dimomite/laser_lever_platform/README.md

# laser lever platform
Platform for remote adjustment rotation and position of a laser level
