dimomite/laser_lever_platform/hardware/mainboard/LaserLevelPlatform/LaserLevelPlatform.kicad_pcb

## KiCad design hardware/mainboard/LaserLevelPlatform/LaserLevelPlatform.kicad_pcb (2022-09-18)

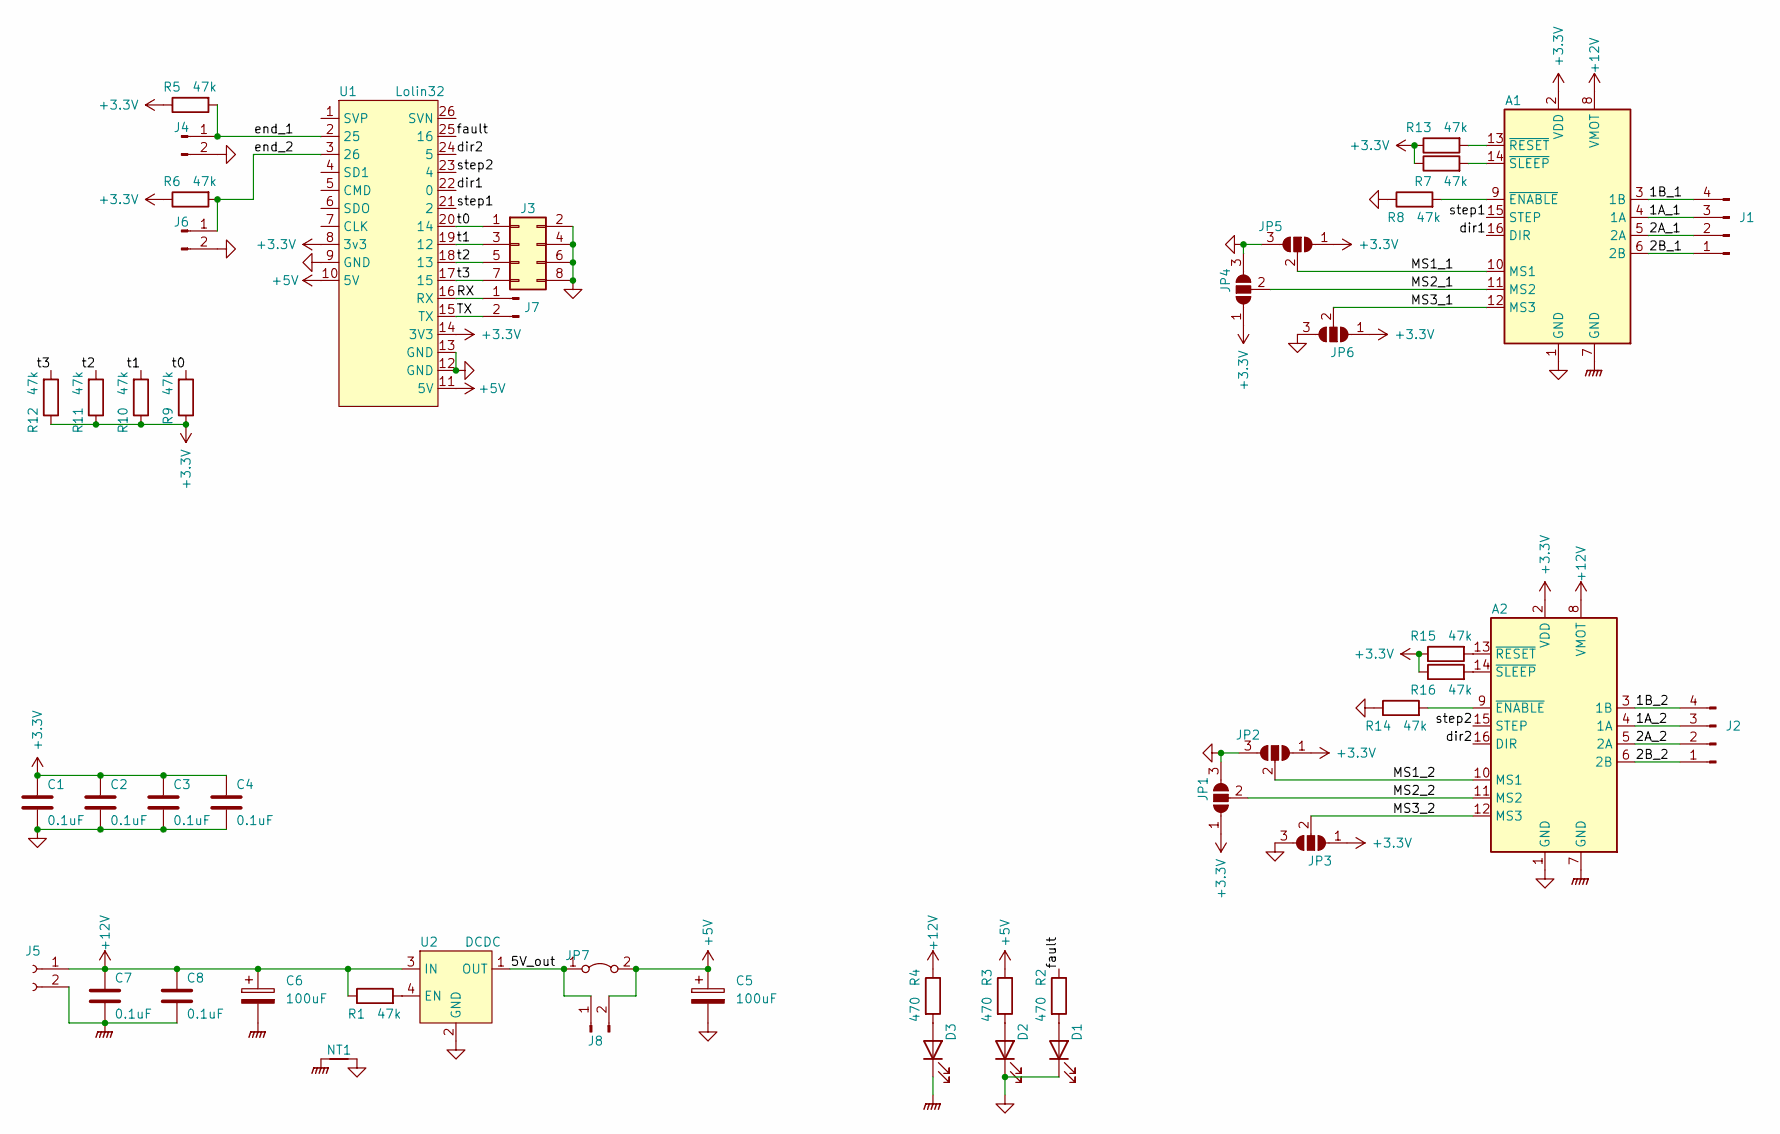
[picture p1: schematic LaserLevelPlatform.kicad_sch]

Parts:
A1, A2: Pololu_Breakout_A4988; Pololu_Breakout-16_15.2x20.3mm
C1, C2, C3, C4, C7, C8: 0.1uF; C_0805_2012Metric_Pad1.18x1.45mm_HandSolder
C5: 100uF; CP_Radial_D10.0mm_P2.50mm_P5.00mm
C6: 100uF; CP_Radial_D10.0mm_P5.00mm
D1, D2, D3: LED; LED_D5.0mm
J1, J2: Conn_01x04_Male; JST_EH_B4B-EH-A_1x04_P2.50mm_Vertical
J3: Conn_02x04_Odd_Even; PinHeader_2x04_P2.54mm_Vertical
J4, J6: Conn_01x02_Male; JST_EH_B2B-EH-A_1x02_P2.50mm_Vertical
J5: Conn_01x02_Female; PhoenixContact_MSTBVA_2,5_2-G-5,08_1x02_P5.08mm_Vertical
J7, J8: Conn_01x02_Male; PinHeader_1x02_P2.54mm_Vertical
JP1, JP2, JP3, JP4, JP5, JP6: SolderJumper_3_Open; SolderJumper-3_P2.0mm_Open_TrianglePad1.0x1.5mm
JP7: Jumper_2_Bridged; SolderJumper-2_P1.3mm_Open_TrianglePad1.0x1.5mm
NT1: NetTie_2; NetTie-2_SMD_Pad2.0mm
R1, R5, R6, R7, R8, R9, R10, R11, R12, R13, R14, R15, R16: 47k; R_0805_2012Metric_Pad1.20x1.40mm_HandSolder
R2, R3, R4: 470; R_0805_2012Metric_Pad1.20x1.40mm_HandSolder
U1: Lolin32
U2: DCDC

Connections:
+3.3V: A1.2 (VDD), A2.2 (VDD), C1.1, C2.1, C3.1, C4.1, JP1.1 (A), JP2.1 (A), JP3.1 (A), JP4.1 (A), JP5.1 (A), JP6.1 (A), R5.1, R6.1, R7.1, R9.1, R10.1, R11.1, R12.1, R13.1, R15.1, R16.1, U1.8 (3v3), U1.14 (3V3)
+5V: C5.1, J8.2, JP7.2 (B), R3.1, U1.10 (5V), U1.11 (5V)
+12V: A1.8 (VMOT), A2.8 (VMOT), C6.1, C7.1, C8.1, J5.1, R1.1, R4.1, U2.3 (IN)
/1A_1: A1.4 (1A), J1.3
/1A_2: A2.4 (1A), J2.3
/1B_1: A1.3 (1B), J1.4
/1B_2: A2.3 (1B), J2.4
/2A_1: A1.5 (2A), J1.2
/2A_2: A2.5 (2A), J2.2
/2B_1: A1.6 (2B), J1.1
/2B_2: A2.6 (2B), J2.1
/5V_out: J8.1, JP7.1 (A), U2.1 (OUT)
/MS1_1: A1.10 (MS1), JP5.2 (C)
/MS1_2: A2.10 (MS1), JP2.2 (C)
/MS2_1: A1.11 (MS2), JP4.2 (C)
/MS2_2: A2.11 (MS2), JP1.2 (C)
/MS3_1: A1.12 (MS3), JP6.2 (C)
/MS3_2: A2.12 (MS3), JP3.2 (C)
/RX: J7.1, U1.16 (RX)
/TX: J7.2, U1.15 (TX)
/dir1: A1.16 (DIR), U1.22 (0)
/dir2: A2.16 (DIR), U1.24 (5)
/end_1: J4.1, R5.2, U1.2 (25)
/end_2: J6.1, R6.2, U1.3 (26)
/fault: R2.1, U1.25 (16)
/step1: A1.15 (STEP), U1.21 (2)
/step2: A2.15 (STEP), U1.23 (4)
/t0: J3.1, R9.2, U1.20 (14)
/t1: J3.3, R10.2, U1.19 (12)
/t2: J3.5, R11.2, U1.18 (13)
/t3: J3.7, R12.2, U1.17 (15)
GND: A1.1 (GND), A2.1 (GND), C1.2, C2.2, C3.2, C4.2, C5.2, D1.1 (K), D2.1 (K), J3.2, J3.4, J3.6, J3.8, J4.2, J6.2, JP1.3 (B), JP2.3 (B), JP3.3 (B), JP4.3 (B), JP5.3 (B), JP6.3 (B), NT1.2, R8.1, R14.1, U1.9 (GND), U1.12 (GND), U1.13 (GND), U2.2 (GND)
GNDPWR: A1.7 (GND), A2.7 (GND), C6.2, C7.2, C8.2, D3.1 (K), J5.2, NT1.1
unnamed: A1.9 (~ENABLE), R8.2
unnamed: A1.13 (~RESET), R13.2
unnamed: A1.14 (~SLEEP), R7.2
unnamed: A2.9 (~ENABLE), R14.2
unnamed: A2.13 (~RESET), R15.2
unnamed: A2.14 (~SLEEP), R16.2
unnamed: D1.2 (A), R2.2
unnamed: D2.2 (A), R3.2
unnamed: D3.2 (A), R4.2
unnamed: R1.2, U2.4 (EN)

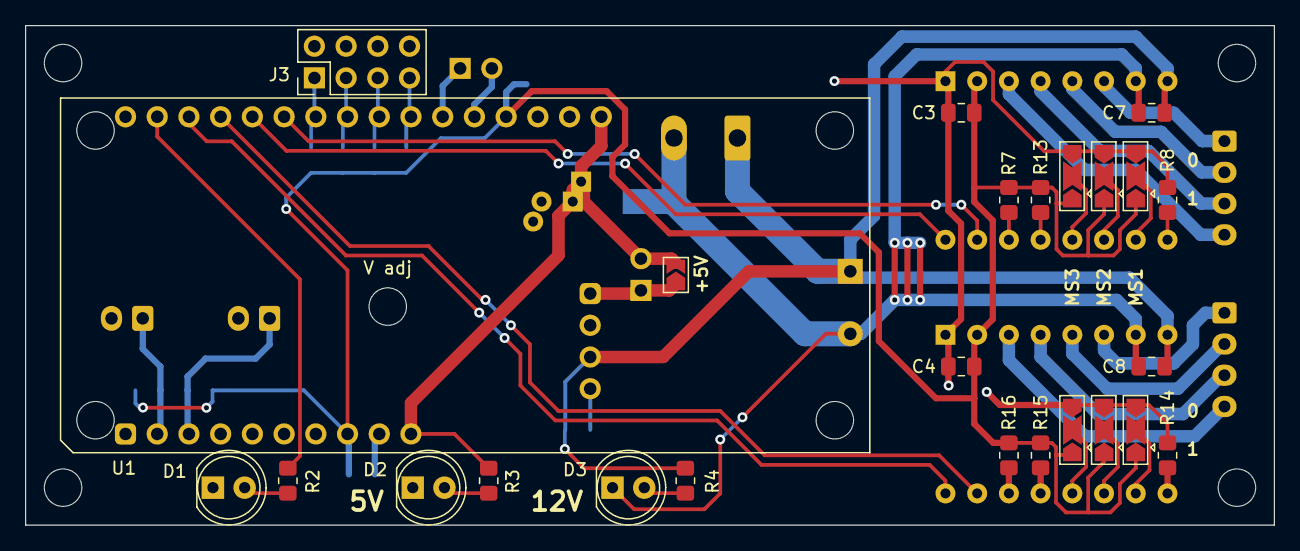
[picture p2: board LaserLevelPlatform.kicad_pcb from above]

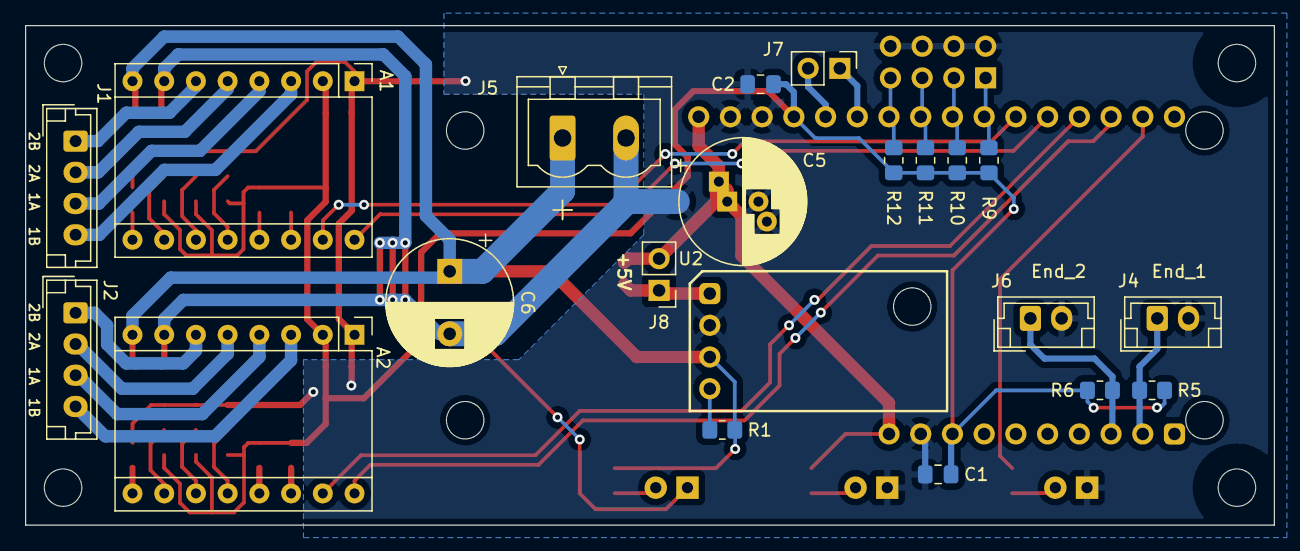
[picture p3: board LaserLevelPlatform.kicad_pcb from below]

Board: 2 copper layers, 100.0 x 40.0 mm, 47 parts (22 on the bottom side), 43 nets.
