dimomite/laser_lever_platform/(commit log)

2022-08-19 Add first implementation
    Added:
    - motor control by hardware buttons/switches
    - support for end stops; error signal when both are active
    simultaniously
    - test connection to the onboard OLED indicator
    - WiFi soft access point implementation
    [main.cpp, remoteserver.cpp, remoteserver.hpp]
2022-08-24 Add local rxjava flow
    Add mini-repo and debug flow updating data every 1 second.
    Add logging with Timber lib.
2022-08-26 Read data from device
    Add Retrofit and Moshi dependencies.
    Add data flow provider reading data from the device.
2022-09-08 PCB design
    Add schematic and pcb.
    [LaserLevelPlatform.kicad_pcb, LaserLevelPlatform.kicad_sch]
2022-09-18 Change outputs to match PCB
    Change application to work on manufactured PCB. It reacts on touch
    events and send output signals for stepper motor. Data is updated approx
    every 50ms. No PWM or interrupts are used at the moment.
2022-09-18 Add jumper on +5V line
    Add a jumper to disconnect +5V power line from DC-DC converter from the
    main CPU board. This is needed for safe connection of a USB power
    together with a +12V input. Also added a bridge in parallel to it for
    the permanent connection.
    [LaserLevelPlatform.kicad_pcb, LaserLevelPlatform.kicad_sch]
2022-10-24 Change movement control to stepper motors
